benoitGIRAUD/Ruche_V4/OUTPUT/PINOUT/pinout_esp32_lora_balance_analogique.png

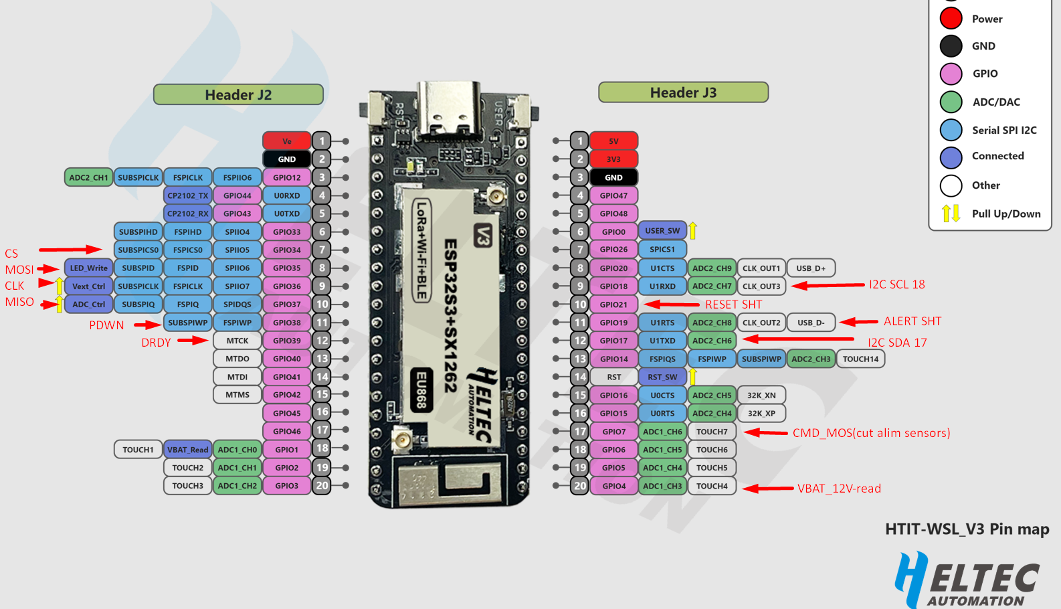
OUTPUT/PINOUT/pinout_esp32_lora_balance_analogique.png
