benoitGIRAUD/Ruche_V4/OUTPUT/SEARCH/Piccoli board_Search.pdf

# Piccoli board

SHT30
Connecteur pratique
IO Micro
Review 23-08

## SHT30

- On remplace le capteur de température DS18B20 par un capteur Temp = Humidité SHT30

Liste SHT30 sur Mouser (https://www.mouser.fr/new/sensirion/sensirion-sht3x-sensors/)

SHT30-DIS-P2.5KS (https://www.mouser.fr/ProductDetail/Sensirion/SHT30-DIS-P2.5KS?qs=F5EMLAvA7ICSBnVxZE%252BVWw%3D%3D)

ou plutot SHT30-DISB avec modele snap (https://www.mouser.fr/ProductDetail/Sensirion/SHT30-DIS-B2.5kS?qs=y6ZabgHbY%252BwVK7712NFj8g%3D%3D) https://www.snapeda.com/parts/SHT30-DIS-B/Sensirion%20AG/view-part/?ref=search&t=SH T30 (https://www.snapeda.com/parts/SHT30-DIS-B/Sensirion%20AG/view-part/?ref=search&t=SHT30)

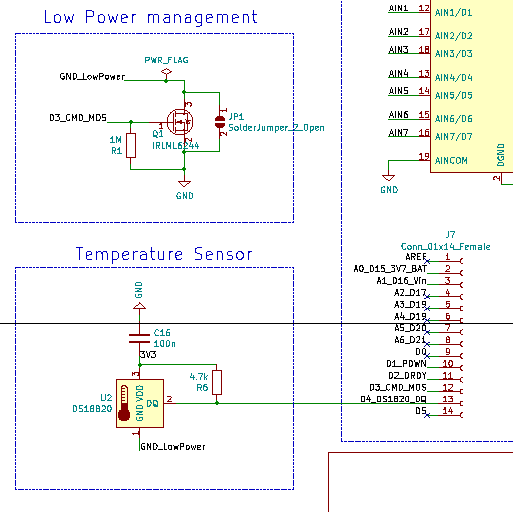
[picture p3: figure]

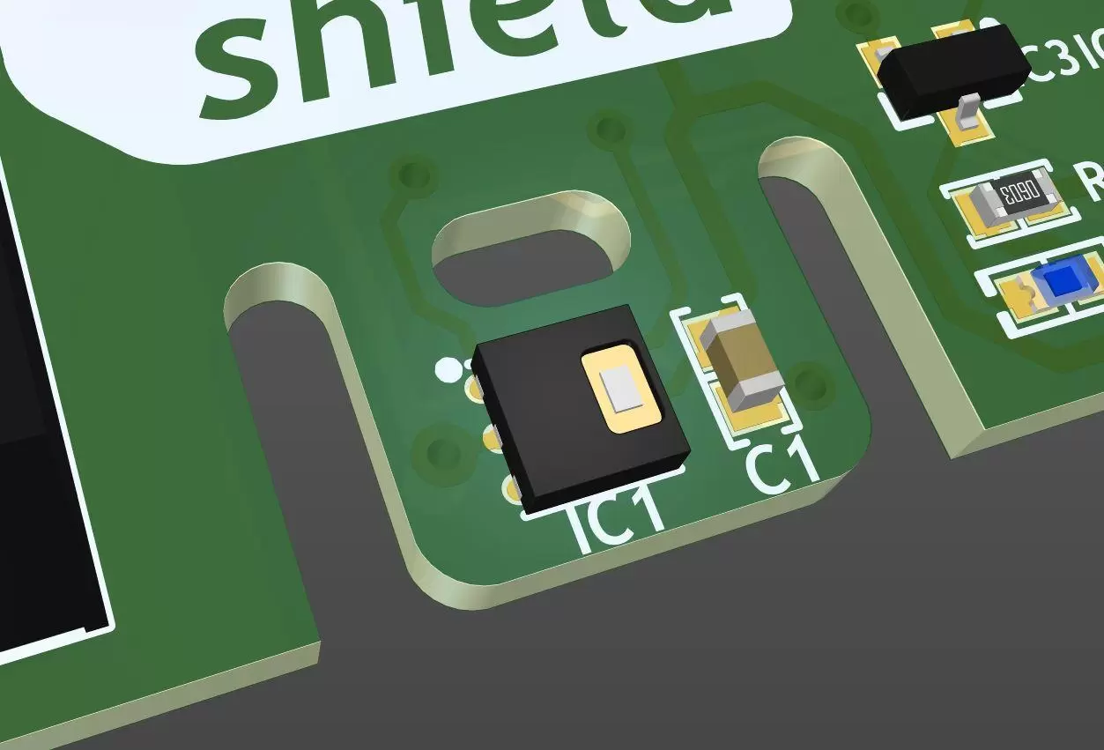
[picture p4: figure]

## Connecteur pratique

- On remplace les connecteurs 4 pos par des connecteurs avec ressorts

Initialement : 691412120004B (https://www.mouser.fr/ProductDetail/Wurth-Elektronik/691412120004B?qs=sPbYRqrBIVnYaxVab3ftDQ%3D%3D) https://www.snapeda.com/parts/691412120004B/W%C3%BCrth%20Elektronik/view-part/?ref=search&t=691412120004B (https://www.snapeda.com/parts/691412120004B/W%C3%BCrth%20Elektronik/view-part/?t=691412120004B)

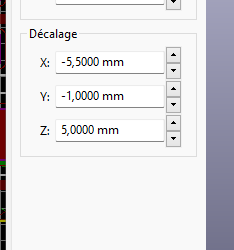
[picture p5: figure]

Le composant monté en réel n’est pas celui sur le sch attention le fil est petit
On l’estime à 0,4 mm de diamètre

Catalogue wuth _ famille 3,5 de pitch (https://www.we-online.com/en/components/products/em/connectors/terminal_blocks/spring_clamp-contbl_wave_soldering_process/spring_clamp_contbl4_wave_soldering_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)

https://www.we-online.com/en/components/products/WR-TBL_SERIES_4101_SCREWLESS_PUSH_IN_3_5MM_PITCH_45___CABLE_ENTRY_THT (https://www.we-online.com/en/components/products/WR-TBL_SERIES_4101_SCREWLESS_PUSH_IN_3_5MM_PITCH_45___CABLE_ENTRY_THT)

possible remplacant
Attente mesure sully
Mesure sully, Fil 17 AWG soit 1mm ²

Donc 691412120004B (https://www.we-online.com/en/components/products/TBL_3_50_412B_SCREWLESS_45-DEGREE_ENTRY_2_1MM2_WIRES_6914121200XXB) est ok
choisi par Lucas
- 3D MODEL pour connecteur d’alim Jack Wurth : https://www.snapeda.com/parts/694108301002/Wurth%20Electronics/view-part/?ref=search&t=694108301002 (https://www.snapeda.com/parts/694108301002/Wurth%20Electronics/view-part/?ref=search&t=694108301002)
- MKWAN commadé par Lucas sur RS
MKWAN rs (https://fr.rs-online.com/web/p/outils-de-developpement-pour-microcontroleurs/2024162)
ABX00029

## IO Micro

https://docs.arduino.cc/hardware/mkr-wan-1310https://docs.arduino.cc/static/4d6f5632f29d78760ecf877790a37b38/ABX00029-full-pinout.pd f (https://docs.arduino.cc/static/4d6f5632f29d78760ecf877790a37b38/ABX00029-full-pinout.pdf)

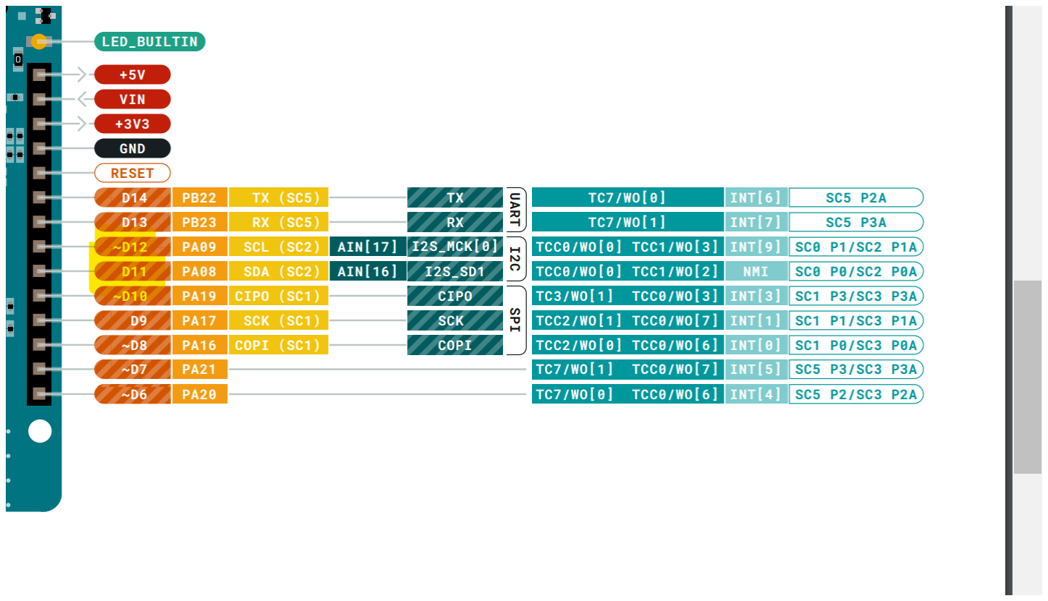
[picture p6: figure]

SCL = D12
SDA = D11

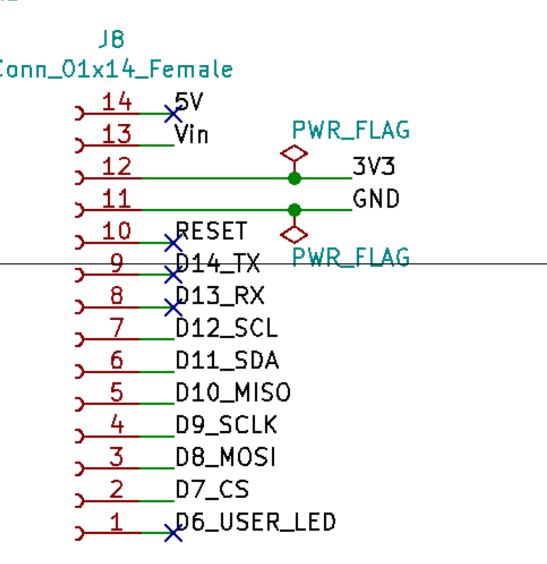
[picture p7: figure]

## Review 23-08

vérifier si dernière version de Lucas Version pull =

### Schéma

Retrait du capteur de Température

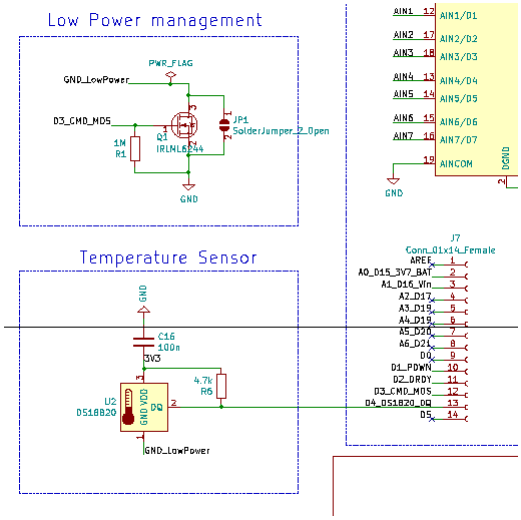
[picture p8: figure]

qui était sur D4

et remplacement par un Capteur de température et humidité SHT30-DIS-B2.5kS (https://www.mouser.fr/ProductDetail/403-SHT30-DIS-B)

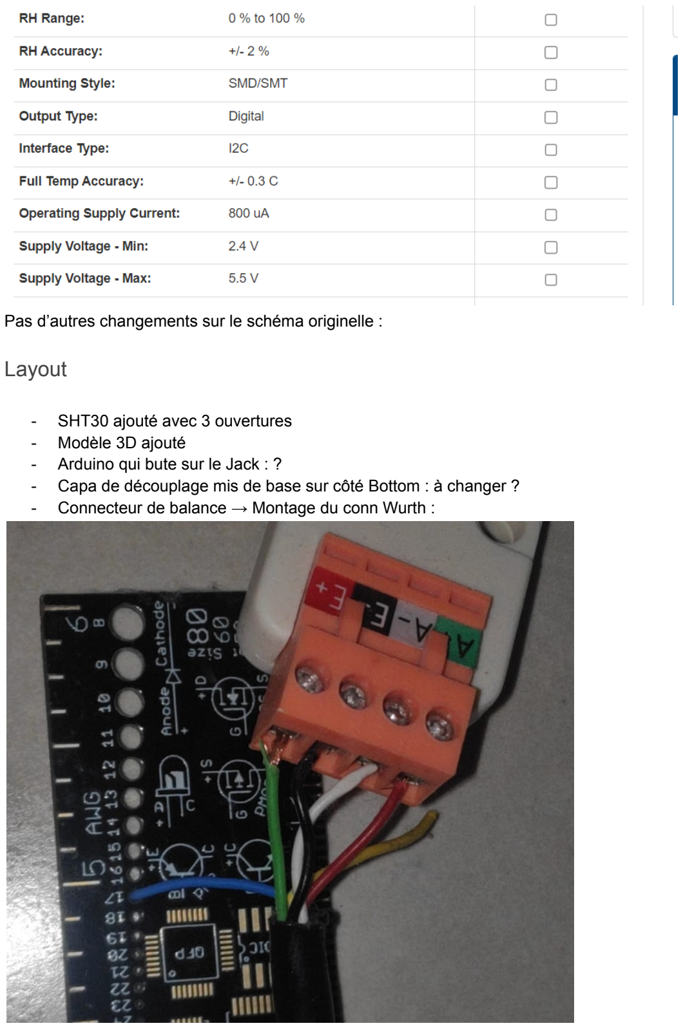
[picture p9: page 8]

Pas d’autres changements sur le schéma originelle :

### Layout

- SHT30 ajouté avec 3 ouvertures
- Modèle 3D ajouté
- Arduino qui bute sur le Jack : ?
- Capa de découplage mis de base sur côté Bottom : à changer ?
- Connecteur de balance → Montage du conn Wurth :

Initialement : 691412120004B (https://www.mouser.fr/ProductDetail/Wurth-Elektronik/691412120004B?qs=sPbYRqrBIVnYaxVab3ftDQ%3D%3D)

Pas d’autres changements sur le layout originelle

### Composants

BOM V4 (https://docs.google.com/spreadsheets/d/1yZju7hxbRTXG5jyiBeL3tfOe9qfSj3zFYfapfLVK23A/edit#gid=0)

BOM repris du Dossier de Lucas :
ajout des 10K, SHT30 et Arduino MK
ajout du jack Male compatible : https://www.mouser.fr/ProductDetail/CUI-Devices/PP3-002B?qs=WyjlAZoYn50CsMst%252B C4ZKw%3D%3D (https://www.mouser.fr/ProductDetail/CUI-Devices/PP3-002B?qs=WyjlAZoYn50CsMst%252BC4ZKw%3D%3D)

Tout sourçable sur Mouser

Hervé est d’accord pour commander pour 2 boards en composants et de passer par JLCPCB

Can :

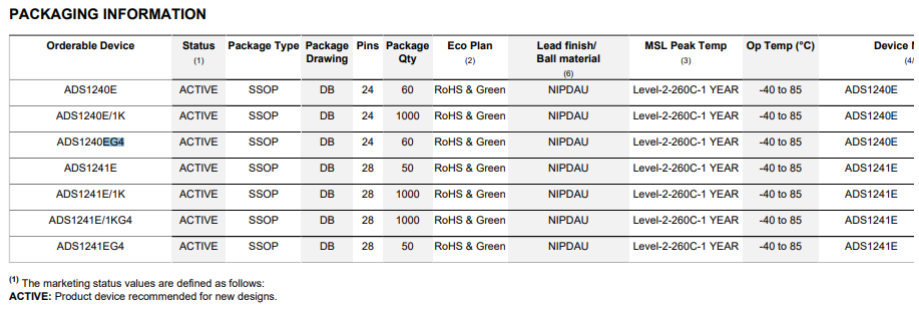
[picture p10: figure]
