benoitGIRAUD/Ruche_V4/OUTPUT/PNG/BeeWeight_MKRWAN_V4_bot.png

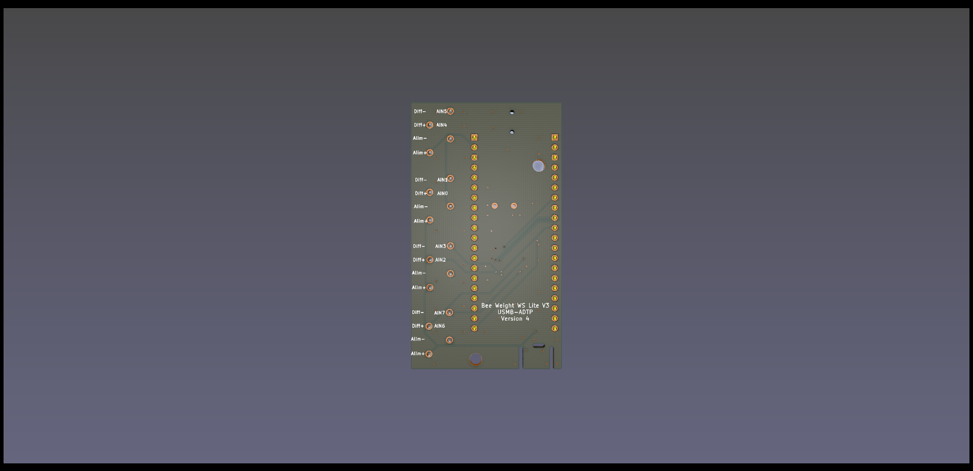
OUTPUT/PNG/BeeWeight_MKRWAN_V4_bot.png
