benoitGIRAUD/Ruche_V4/V-Heltec/HTIT-WS_V3_J2-Gauche.png

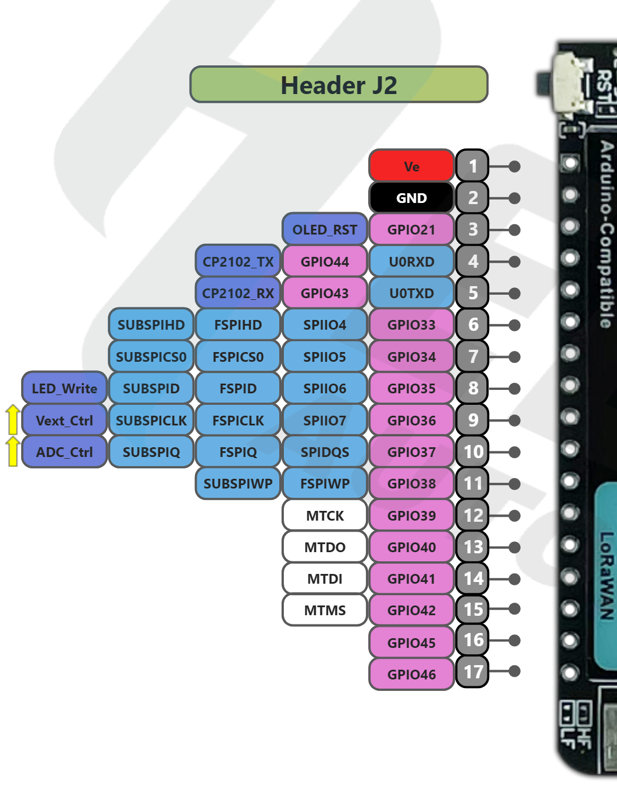
V-Heltec/HTIT-WS_V3_J2-Gauche.png
