benoitGIRAUD/Ruche_V4/V-Heltec/HTIT-WS_V3_J3-Droite - Copie.png

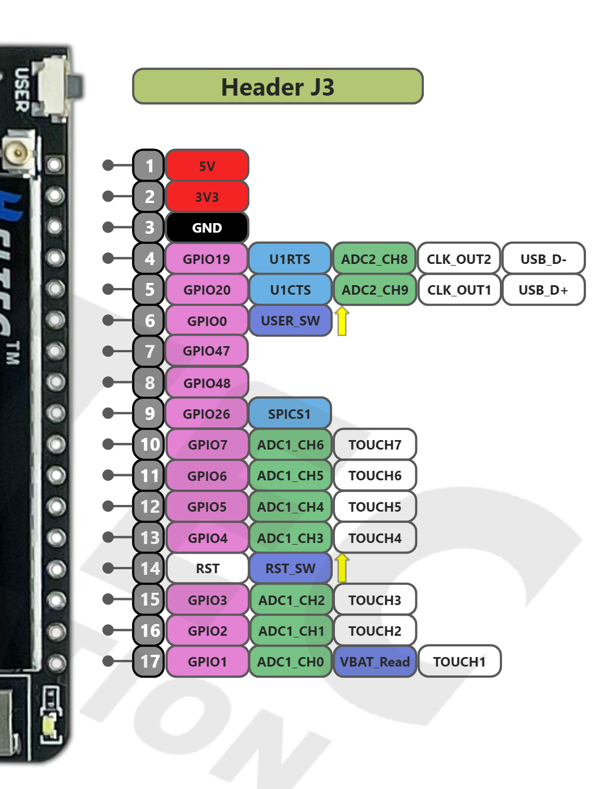
V-Heltec/HTIT-WS_V3_J3-Droite - Copie.png
