benoitGIRAUD/Ruche_V4/V-Heltec/Stick Lite V3/HTIT-WSL_V3_Pinout-Droite.png

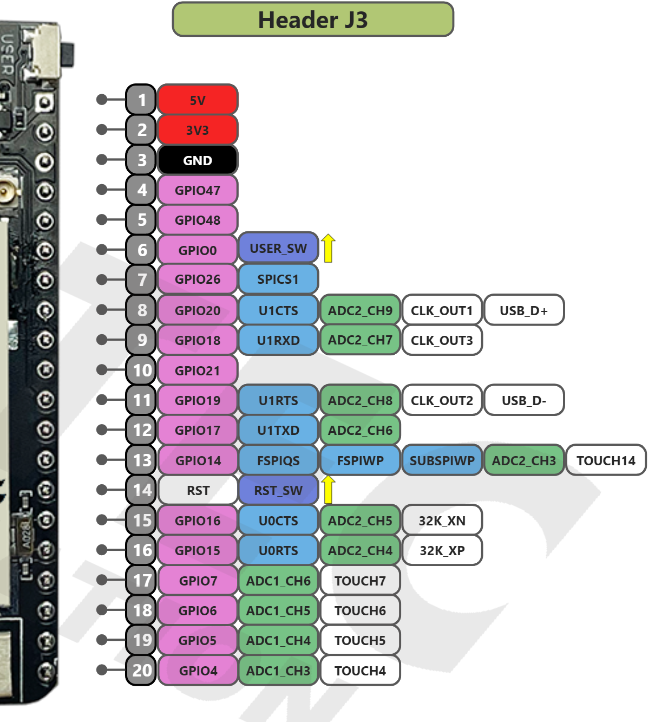
V-Heltec/Stick Lite V3/HTIT-WSL_V3_Pinout-Droite.png
