benoitGIRAUD/Ruche_V4/V-Heltec/Stick Lite V3/wsl_V3 pin map.jpg

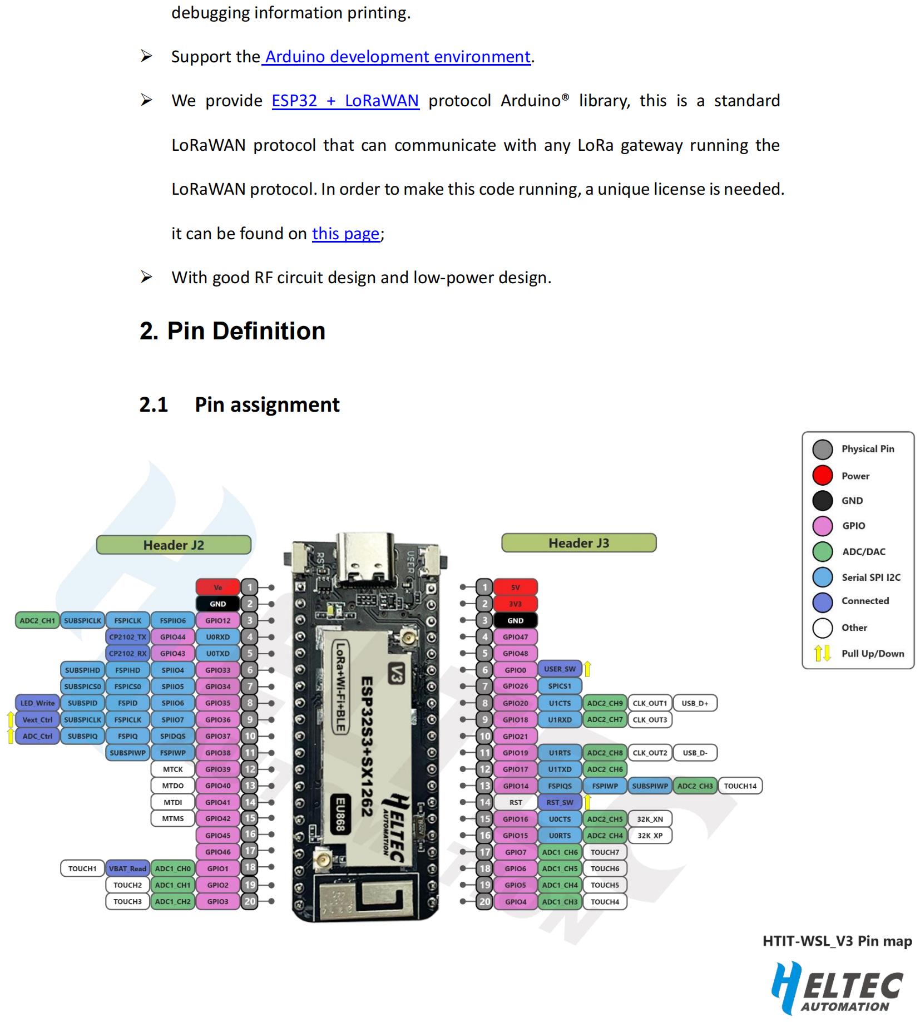
V-Heltec/Stick Lite V3/wsl_V3 pin map.jpg
