benoitGIRAUD/Ruche_V4/OUTPUT/BOM/CAPPAZ_V4_BOM.xlsx

Composants |  | Quantité | Référence
Résistances 0805 | 1 MΩ | 2
 | 560 kΩ | 1
 | 330 kΩ | 1
 | 100 kΩ | 1
 | 4,7kΩ | 1
Condensateurs 0603 | 100 nF | 6
 | 10 nF | 8
 | 18 pF | 2
Capteur T°/Humidité |  | 1 | SHT30-DIS-B2.5kS
Bornier 4 contacts |  | 4 | 691412120004B
CAN |  | 1 | ADS1241E
Semiconducteur |  | 1 | IRLML6244
Connecteur d'alimentation |  | 1 | 694108301002
Oscillateur |  | 1 | U-S4000000ABJB
Connecteur femelle transversant droit 1*14 2,54mm |  | 2 | SSW-114-01-G-S
Module LoRa |  | 1 | ABX00029
