benoitGIRAUD/Ruche_V4/V-Heltec/WirelessStick_3D_drawing(SolidWorks2014)/WirelessStick_3D_drawing(SolidWorks2014)/WirelessStick.SLDASM

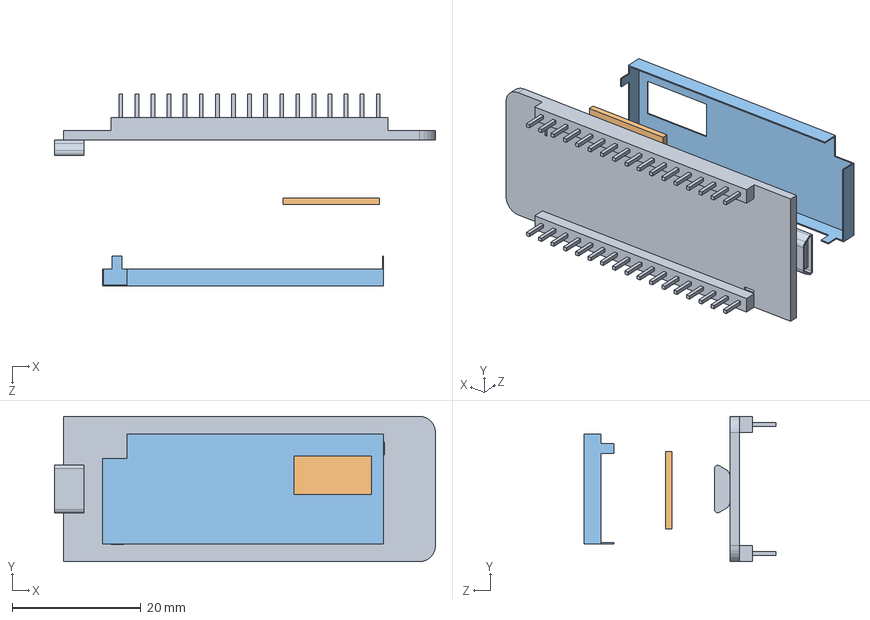
[picture p16: CAD file, 2023-08-28]
V-Heltec/WirelessStick_3D_drawing(SolidWorks2014)/WirelessStick_3D_drawing(SolidWorks2014)/WirelessStick.SLDASM
59.2 x 22.6 x 29.9 mm
C-DZB
C-YJP
C-HZ
