benoitGIRAUD/Ruche_V4/V-Heltec/C-DZB_WirelessStickV3_fromTech.STEP

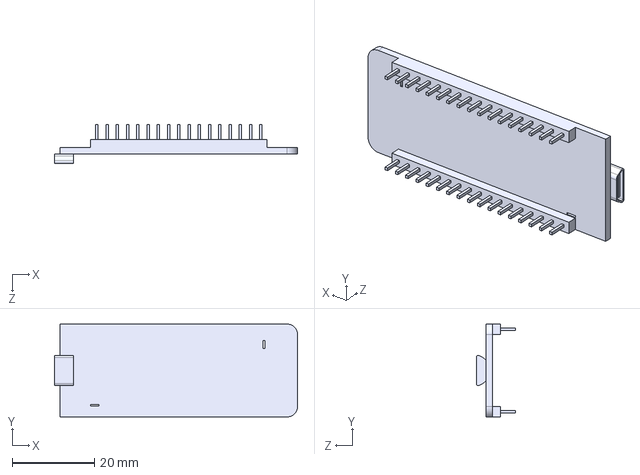
[picture p17: CAD file, 2023-08-28]
V-Heltec/C-DZB_WirelessStickV3_fromTech.STEP
59.2 x 22.6 x 9.60 mm
