benoitGIRAUD/Ruche_V4/V-Heltec/SSW-117-01-G-S/SSW-117-01-G-S.step

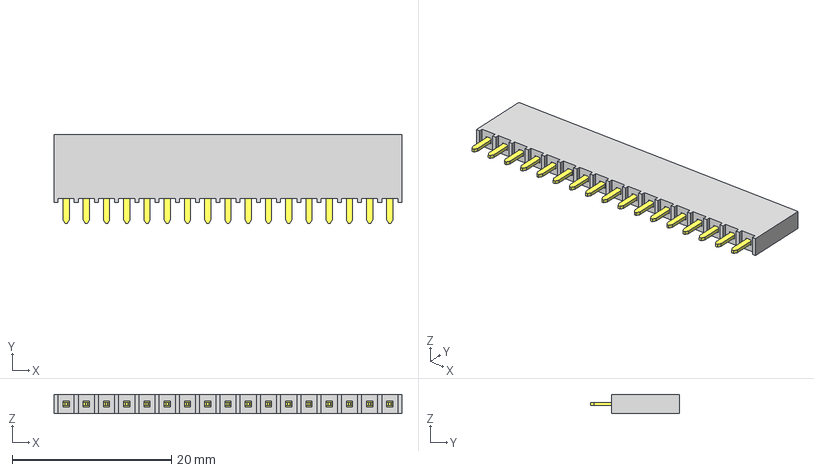
[picture p18: CAD file, 2023-08-28]
V-Heltec/SSW-117-01-G-S/SSW-117-01-G-S.step
43.7 x 11.2 x 2.41 mm
P2SSW-117-01-G-S
T1SSW-117-01-G-S
