benoitGIRAUD/Ruche_V4/V-Heltec/Stick Lite V3/LDL1117S33R/LDL1117S33R.step

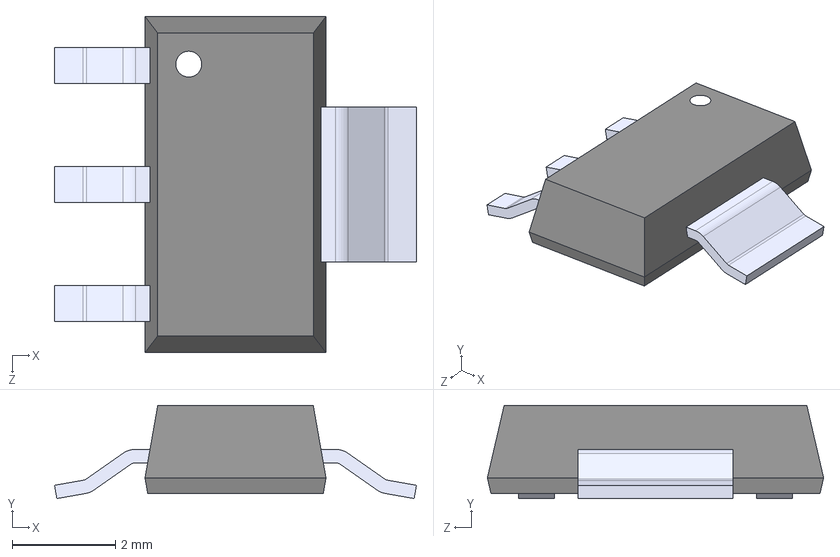
[picture p19: CAD file, 2023-08-28]
V-Heltec/Stick Lite V3/LDL1117S33R/LDL1117S33R.step
7.00 x 1.80 x 6.50 mm
