benoitGIRAUD/Ruche_V4/V-Heltec/Stick Lite V3/SSW-120-01-X-S/SSW-120-01-X-S.step

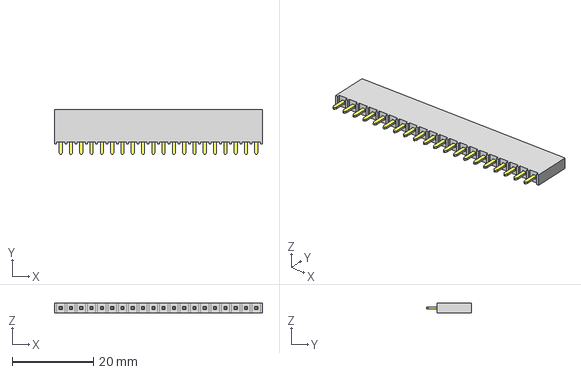
[picture p20: CAD file, 2023-08-28]
V-Heltec/Stick Lite V3/SSW-120-01-X-S/SSW-120-01-X-S.step
51.3 x 11.2 x 2.41 mm
P2SSW-120-01-G-S
T1SSW-120-01-G-S
