benoitGIRAUD/Ruche_V4/V-Heltec/Wireless Stick.STEP

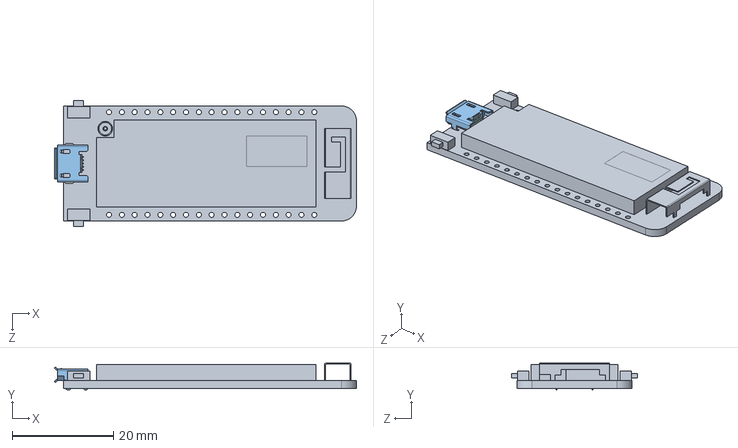
[picture p21: CAD file, 2023-08-28]
V-Heltec/Wireless Stick.STEP
59.8 x 5.26 x 25.0 mm
Wireless Stick模型示意图
micro usb
