benoitGIRAUD/Ruche_V4/(list of files, cad)

Other CAD files:
V-Heltec/WirelessStick_3D_drawing(SolidWorks2014)/WirelessStick_3D_drawing(SolidWorks2014)/C-YJP.sldprt
V-Heltec/WirelessStick_3D_drawing(SolidWorks2014)/WirelessStick_3D_drawing(SolidWorks2014)/C-DZB.sldprt
V-Heltec/WirelessStick_3D_drawing(SolidWorks2014)/WirelessStick_3D_drawing(SolidWorks2014)/C-HZ.sldprt
