benoitGIRAUD/Ruche_V4/OUTPUT/SCH/CAPAZ_V4_SCH.pdf

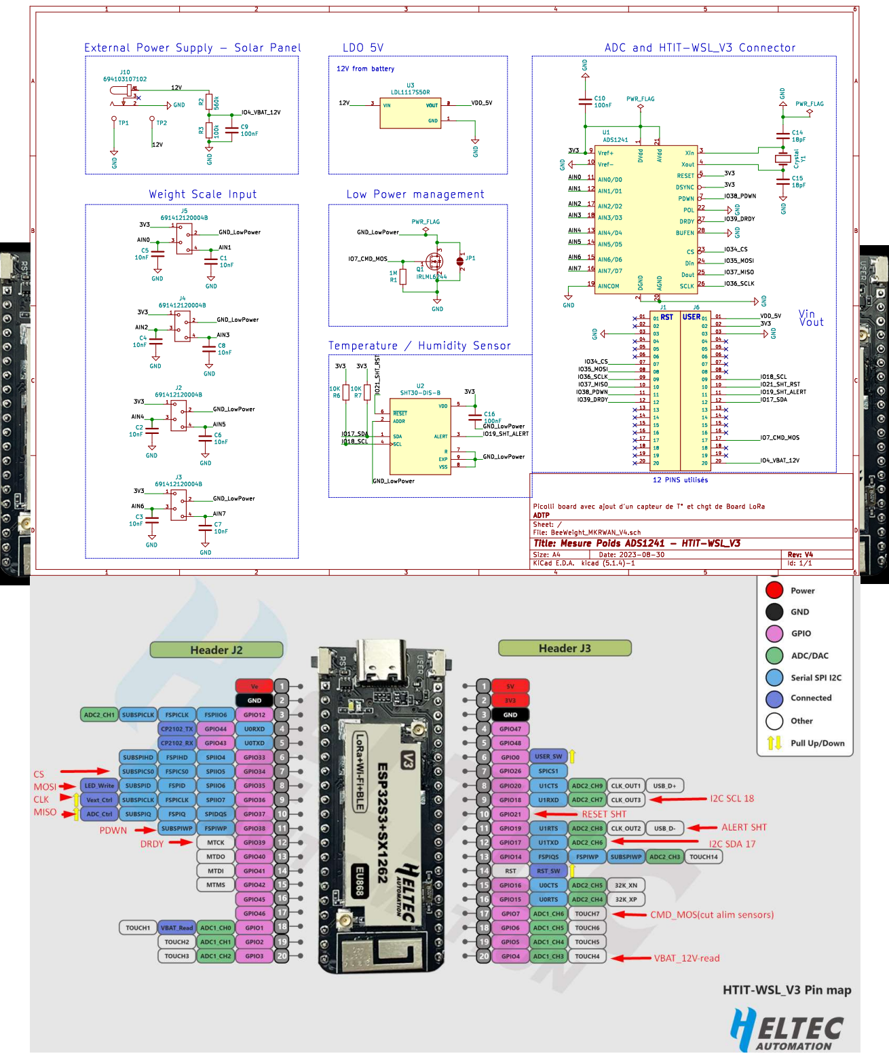
[picture p22: page 1]
