benoitGIRAUD/Ruche_V4/(list of files, drawings)

Other design files:
OUTPUT/SPECTRA/BeeWeight_MKRWAN_V4.dsn
