benoitGIRAUD/Ruche_V4/BeeWeight_MKRWAN_V4/BeeWeight_MKRWAN_V4.kicad_pcb

## KiCad design BeeWeight_MKRWAN_V4/BeeWeight_MKRWAN_V4.kicad_pcb (2023-08-30)

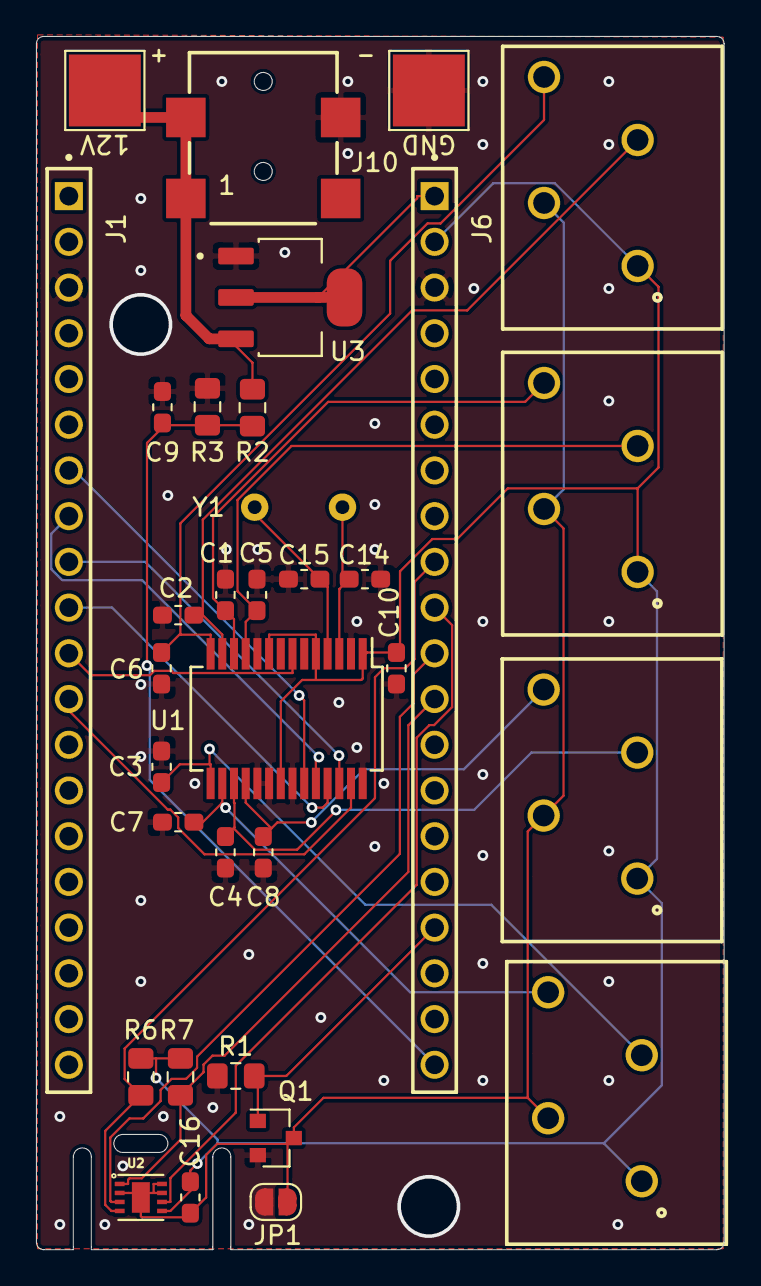
[picture p23: board BeeWeight_MKRWAN_V4.kicad_pcb from above]

Board: 4 copper layers, 38.2 x 67.4 mm, 33 parts (0 on the bottom side), 27 nets.

Parts:
12V: TestPoint; TestPoint_Pad_4.0x4.0mm
C1, C2, C3, C4, C5, C6, C7, C8: 10nF; C_0603_1608Metric_Pad1.05x0.95mm_HandSolder
C9, C10, C16: 100nF; C_0603_1608Metric_Pad1.05x0.95mm_HandSolder
C14, C15: 18pF; C_0603_1608Metric_Pad1.05x0.95mm_HandSolder
GND: TestPoint; TestPoint_Pad_4.0x4.0mm
J1, J6: SSW-120-01-X-S; SAMTEC_SSW-120-01-X-S
J2, J3, J4, J5: 691412120004B; TermBlock_1x04_P3.50mm Wurth_691412120004B
J10: 694103107102
JP1: SolderJumper_2_Open; SolderJumper-2_P1.3mm_Open_RoundedPad1.0x1.5mm
Q1: IRLML6244; SOT-23
R1: 1M; R_0805_2012Metric_Pad1.15x1.40mm_HandSolder
R2: 560k; R_0805_2012Metric_Pad1.15x1.40mm_HandSolder
R3: 100k; R_0805_2012Metric_Pad1.15x1.40mm_HandSolder
R6, R7: 10K; R_0805_2012Metric_Pad1.15x1.40mm_HandSolder
U1: ADS1241
U2: SHT30-DIS-B; DFN250X250X100-9N
U3: LDL1117S50R; SOT230P700X180-4N
Y1: Crystal; Crystal-4Mhz-TH-Wurth-830027298B

Connections:
/3V3: C10.2, C16.1, J2.1, J3.1, J4.1, J5.1, J6.02, R6.2, R7.2, U1.1, U1.5, U1.9, U1.21, U2.5
/12V: 12V.1, J10.1, J10.A1, R2.2, U3.3
/AIN0: C5.1, J5.3, U1.11
/AIN1: C1.1, J5.4, U1.12
/AIN2: C4.1, J4.3, U1.17
/AIN3: C8.1, J4.4, U1.18
/AIN4: C2.1, J2.3, U1.13
/AIN5: C6.1, J2.4, U1.14
/AIN6: C3.1, J3.3, U1.15
/AIN7: C7.1, J3.4, U1.16
/GND_LowPower: C16.2, J2.2, J3.2, J4.2, J5.2, JP1.1, Q1.3, U2.2, U2.7, U2.8, U2.9
/IO4_VBAT_12V: C9.1, J6.20, R2.1, R3.2
/IO7_CMD_MOS: J6.17, Q1.1, R1.2
/IO17_SDA: J6.12, R7.1, U2.1
/IO18_SCL: J6.09, R6.1, U2.4
/IO19_SHT_ALERT: J6.11, U2.3
/IO21_SHT_RST: J6.10, U2.6
/IO34_CS: J1.07, U1.23
/IO35_MOSI: J1.08, U1.24
/IO36_SCLK: J1.09, U1.26
/IO37_MISO: J1.10, U1.25
/IO38_PDWN: J1.11, U1.7
/IO39_DRDY: J1.12, U1.27
/VDD_5V: J6.01, U3.2, U3.4
GND: C1.2, C2.2, C3.2, C4.2, C5.2, C6.2, C7.2, C8.2, C9.2, C10.1, C14.1, C15.2, GND.1, J1.03, J6.03, J10.2, JP1.2, Q1.2, R1.1, R3.1, U1.2, U1.10, U1.19, U1.20, U1.22, U1.28, U3.1
unnamed: C14.2, U1.3, Y1.1
unnamed: C15.1, U1.4, Y1.2
