benoitGIRAUD/Ruche_V4/OLD_V3/BeeWeight_MKRWAN - Modif/BeeWeight_MKRWAN.kicad_pcb

## KiCad design OLD_V3/BeeWeight_MKRWAN - Modif/BeeWeight_MKRWAN.kicad_pcb (2023-08-28, an earlier design)

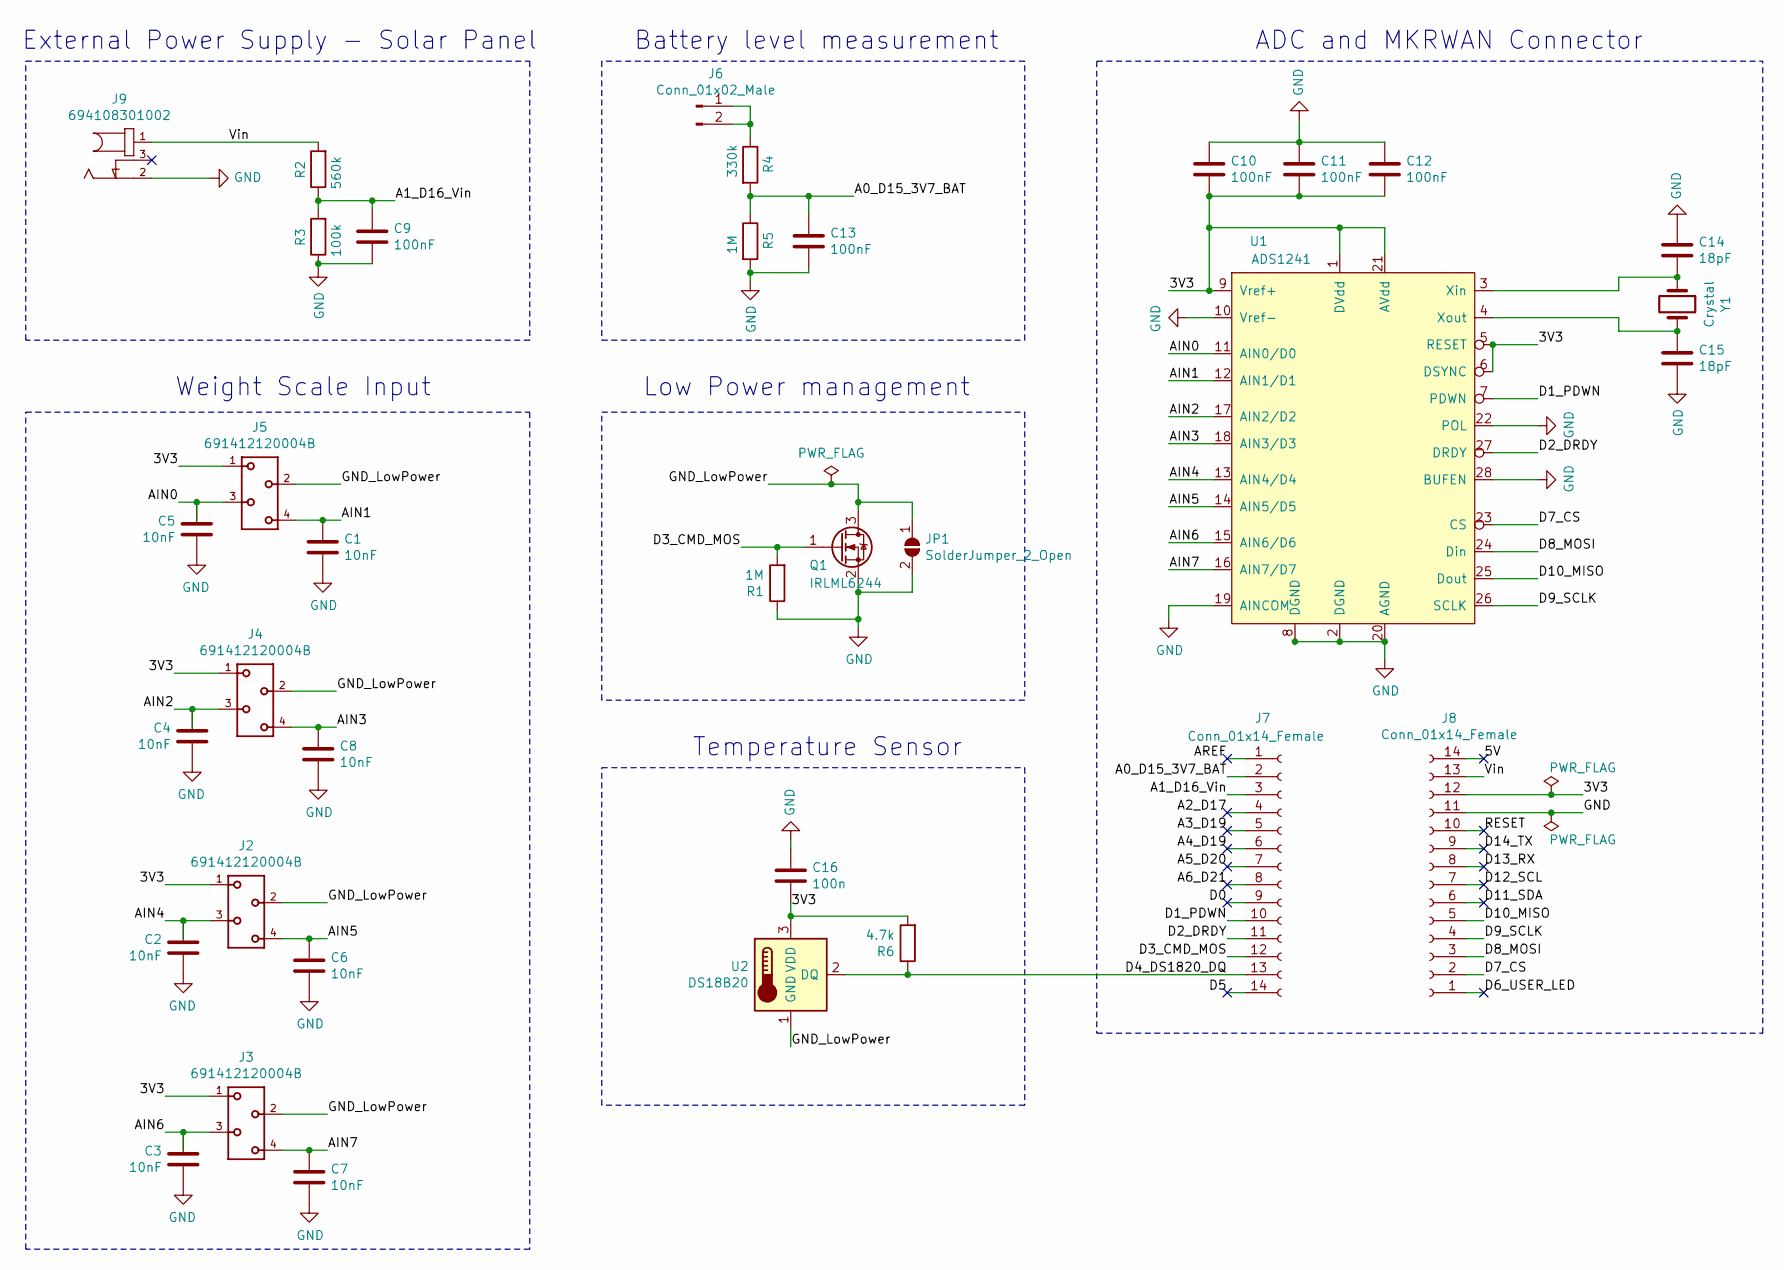
[picture p24: schematic BeeWeight_MKRWAN.sch, Mesure Poids ADS1241 MKRWAN1310]

Parts:
C1, C2, C3, C4, C5, C6, C7, C8: 10nF; C_0603_1608Metric_Pad1.05x0.95mm_HandSolder
C9, C10, C11, C12, C13: 100nF; C_0603_1608Metric_Pad1.05x0.95mm_HandSolder
C14, C15: 18pF; C_0603_1608Metric_Pad1.05x0.95mm_HandSolder
C16: 100n; C_0603_1608Metric_Pad1.05x0.95mm_HandSolder
J2, J3, J4, J5: 691412120004B; TermBlock_1x04_P3.50mm Wurth_691412120004B; PART-NUMBER 691412120004B
J6: Conn_01x02_Male; PinHeader_1x02_P2.54mm_Horizontal
J7, J8: Conn_01x14_Female; PinSocket_1x14_P2.54mm_Vertical
J9: 694108301002; Jack_DC_2.1mm Wurth_694108301002; PART-NUMBER 694108301002
JP1: SolderJumper_2_Open; SolderJumper-2_P1.3mm_Open_RoundedPad1.0x1.5mm
Q1: IRLML6244; SOT-23
R1, R5: 1M; R_0805_2012Metric_Pad1.15x1.40mm_HandSolder
R2: 560k; R_0805_2012Metric_Pad1.15x1.40mm_HandSolder
R3: 100k; R_0805_2012Metric_Pad1.15x1.40mm_HandSolder
R4: 330k; R_0805_2012Metric_Pad1.15x1.40mm_HandSolder
R6: 4.7k; R_0805_2012Metric_Pad1.15x1.40mm_HandSolder
U1: ADS1241
U2: DS18B20; TO-92
Y1: Crystal; Crystal-4Mhz-TH-Wurth-830027298B

Connections:
/3V3: C10.2, C11.2, C12.2, C16.2, J2.1, J3.1, J4.1, J5.1, J8.12, R6.2, U1.1 (DVdd), U1.5 (RESET), U1.6 (DSYNC), U1.9 (Vref+), U1.21 (AVdd), U2.3 (VDD)
/5V: J8.14
/A0_D15_3V7_BAT: C13.1, J7.2, R4.2, R5.1
/A1_D16_Vin: C9.1, J7.3, R2.1, R3.2
/A2_D17: J7.4
/A3_D19: J7.5
/A4_D19: J7.6
/A5_D20: J7.7
/A6_D21: J7.8
/AIN0: C5.1, J5.3, U1.11 (AIN0/D0)
/AIN1: C1.1, J5.4, U1.12 (AIN1/D1)
/AIN2: C4.1, J4.3, U1.17 (AIN2/D2)
/AIN3: C8.1, J4.4, U1.18 (AIN3/D3)
/AIN4: C2.1, J2.3, U1.13 (AIN4/D4)
/AIN5: C6.1, J2.4, U1.14 (AIN5/D5)
/AIN6: C3.1, J3.3, U1.15 (AIN6/D6)
/AIN7: C7.1, J3.4, U1.16 (AIN7/D7)
/AREF: J7.1
/D0: J7.9
/D1_PDWN: J7.10, U1.7 (PDWN)
/D2_DRDY: J7.11, U1.27 (DRDY)
/D3_CMD_MOS: J7.12, Q1.1 (G), R1.2
/D4_DS1820_DQ: J7.13, R6.1, U2.2 (DQ)
/D5: J7.14
/D6_USER_LED: J8.1
/D7_CS: J8.2, U1.23 (CS)
/D8_MOSI: J8.3, U1.24 (Din)
/D9_SCLK: J8.4, U1.26 (SCLK)
/D10_MISO: J8.5, U1.25 (Dout)
/D11_SDA: J8.6
/D12_SCL: J8.7
/D13_RX: J8.8
/D14_TX: J8.9
/GND_LowPower: J2.2, J3.2, J4.2, J5.2, JP1.1 (A), Q1.3 (D), U2.1 (GND)
/RESET: J8.10
/Vin: J8.13, J9.1, R2.2
GND: C1.2, C2.2, C3.2, C4.2, C5.2, C6.2, C7.2, C8.2, C9.2, C10.1, C11.1, C12.1, C13.2, C14.1, C15.2, C16.1, J8.11, J9.2, JP1.2 (B), Q1.2 (S), R1.1, R3.1, R5.2, U1.2 (DGND), U1.8 (DGND), U1.10 (Vref-), U1.19 (AINCOM), U1.20 (AGND), U1.22 (POL), U1.28 (BUFEN)
unnamed: C14.2, U1.3 (Xin), Y1.1
unnamed: C15.1, U1.4 (Xout), Y1.2
unnamed: J6.1, J6.2, R4.1

Notes on the sheet:
External Power Supply - Solar Panel
Weight Scale Input
Battery level measurement
Low Power management
Temperature Sensor
ADC and MKRWAN Connector

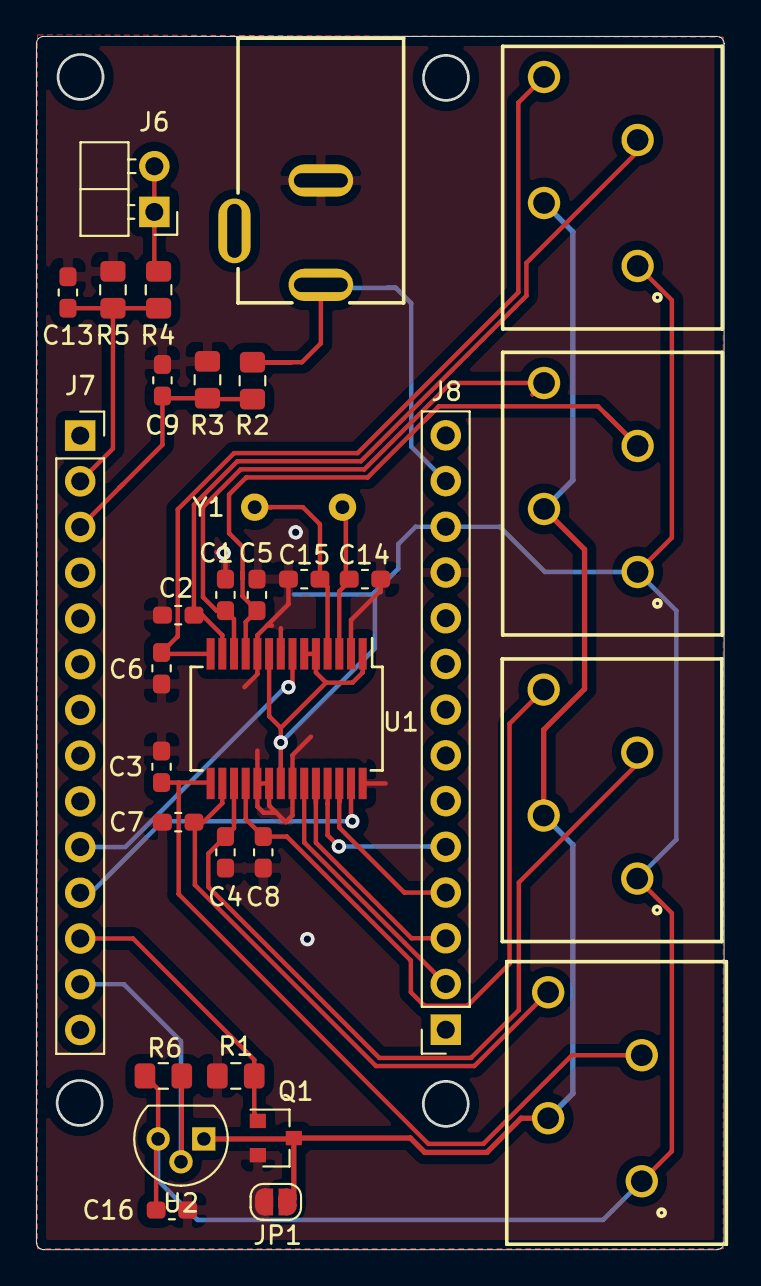
[picture p25: board BeeWeight_MKRWAN.kicad_pcb from above]

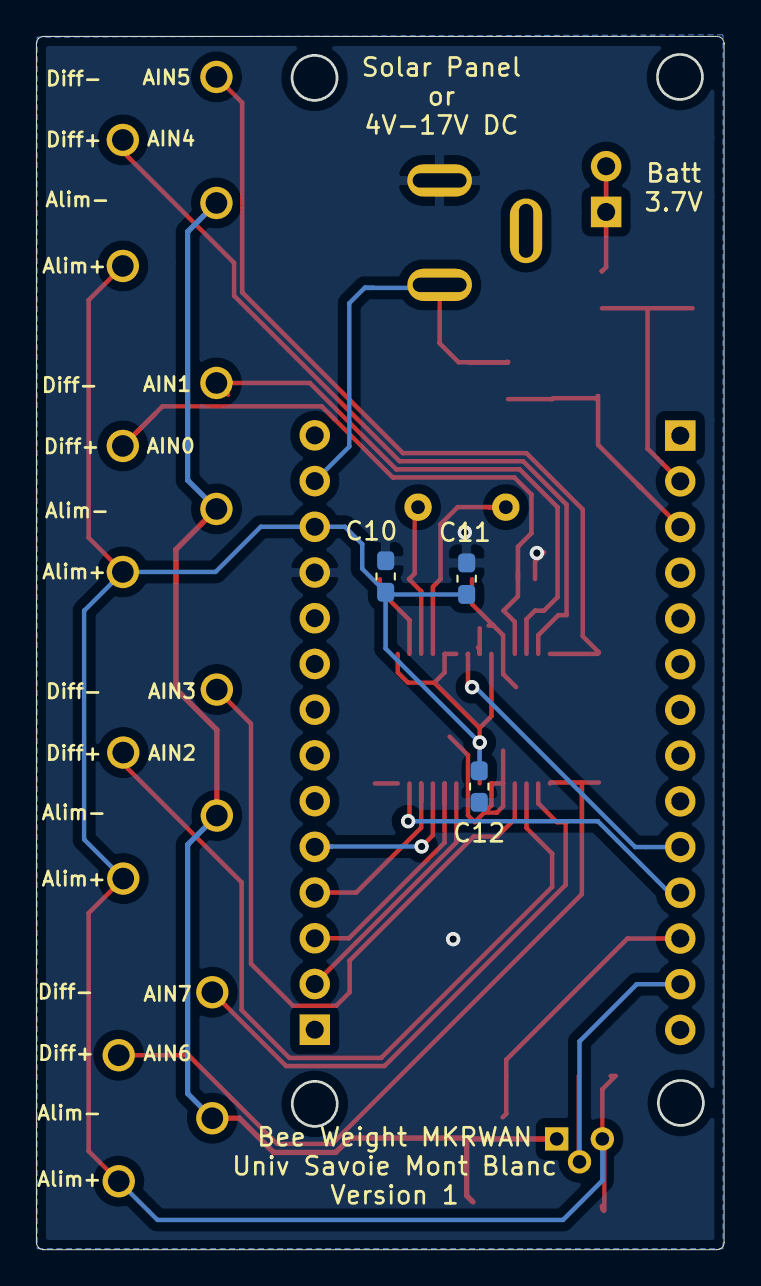
[picture p26: board BeeWeight_MKRWAN.kicad_pcb from below]

Board: 2 copper layers, 38.2 x 67.4 mm, 35 parts (3 on the bottom side), 25 nets.
