benoitGIRAUD/Ruche_V4/(commit log)

2023-08-28 Recuperation CAO sur NAS + V-Heltec
    [2022-01-10_ Liste des composants à commander.xlsx, BeeWeight_MKRWAN.kicad_pcb, BeeWeight_MKRWAN.sch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]
2023-08-28 ajout new componets and new board in folder
    [C-DZB.sldprt, C-DZB_WirelessStickV3_fromTech.STEP, C-HZ.sldprt, C-YJP.sldprt, LDL1117S33R.step, SSW-117-01-G-S.step, SSW-120-01-X-S.step, Wireless Stick.STEP]
2023-08-28 Lundi soir : en cours de pin mapping
    [BeeWeight_MKRWAN_V4.kicad_pcb, BeeWeight_MKRWAN_V4.sch]
2023-08-29 Mardi soir: pinout routé sur le schematic
    [BeeWeight_MKRWAN_V4.kicad_pcb]
2023-08-29 Tout mis au propre (chemin + pistes et positions)
    [BeeWeight_MKRWAN_V4.kicad_pcb]
2023-08-30 Send to JLCPCB
    [BeeWeight_MKRWAN_V4-B_Mask.gbr, BeeWeight_MKRWAN_V4-B_Paste.gbr, BeeWeight_MKRWAN_V4-B_SilkS.gbr, BeeWeight_MKRWAN_V4-Back.gbr, BeeWeight_MKRWAN_V4-Edge_Cuts.gbr, BeeWeight_MKRWAN_V4-F_Mask.gbr, BeeWeight_MKRWAN_V4-F_Paste.gbr, BeeWeight_MKRWAN_V4-F_SilkS.gbr]
