benoitGIRAUD/Ruche_V4/(notices)

Notices in the files:
V-Heltec/SSW-117-01-G-S/SSW-117-01-G-S.step:
author */ ('License CC BY-ND 4.0'),
